anticolon/AutoLee/AutoLee/web_server.h

// ============================================================================
//  AutoLee – web_server.h
//  Web server, API endpoints, SSE broadcast, captive portal, OTA upload
// ============================================================================
#pragma once

#include <Update.h>
// All globals and forward declarations are provided by AutoLee.ino
// (single translation unit — Arduino IDE model)

// ==========================================================================
//  STATE JSON BUILDER
// ==========================================================================
// Escape a string for embedding in JSON (quotes, backslashes, control chars)
static String jsonEscape(const String &s) {
  String out;
  out.reserve(s.length() + 8);
  for (size_t i = 0; i < s.length(); i++) {
    char c = s[i];
    if (c == '"')       out += "\\\"";
    else if (c == '\\') out += "\\\\";
    else if ((uint8_t)c >= 0x20) out += c;  // drop control chars
  }
  return out;
}

static String buildStateJSON() {
  char buf[1280];
  const char *wfStat = wifiConnected ? "Connected" : (wifiAPMode ? "AP Mode" : "Disconnected");
  String wfSSID = jsonEscape(wifiConnected ? WiFi.SSID() : (wifiAPMode ? String(DEFAULT_AP_SSID) : String("—")));
  String wfIP = wifiConnected ? WiFi.localIP().toString() : (wifiAPMode ? WiFi.softAPIP().toString() : String("—"));
  int n = snprintf(buf, sizeof(buf),
    "{\"version\":\"%s\",\"state\":\"%s\",\"counter\":%ld,\"speed\":%lu,\"calibrated\":%s,"
    "\"rawUp\":%ld,\"rawDown\":%ld,\"endpointUp\":%ld,\"endpointDown\":%ld,"
    "\"upOffset\":%ld,\"downOffset\":%ld,\"position\":%ld,\"sgTrip\":%u,"
    "\"workZone\":%ld,\"currentMa\":%u,\"sgMin\":%u,\"sgMax\":%u,\"autoSG\":%s,\"sgCal\":%s,"
    "\"profileIdx\":%u,\"profileName\":\"%s\",\"pendingProfile\":%d,"
    "\"profiles\":[{\"name\":\"Slow\",\"hz\":%lu,\"sg\":%u,\"floor\":%s},"
    "{\"name\":\"Normal\",\"hz\":%lu,\"sg\":%u,\"floor\":%s},"
    "{\"name\":\"Fast\",\"hz\":%lu,\"sg\":%u,\"floor\":%s}],"
    "\"wifiEnabled\":%s,\"wifiStatus\":\"%s\",\"wifiSSID\":\"%s\",\"wifiIP\":\"%s\","
    "\"batchTarget\":%ld,\"batchCount\":%ld,\"batchActive\":%s}",
    FW_VERSION,
    runState==RUNNING?"RUNNING":runState==STOPPING?"STOPPING":runState==CALIBRATING?"CALIBRATING":runState==STALLED?"STALLED":runState==HOMING?"HOMING":"IDLE",
    counter, (unsigned long)ui_speed_hz, endpointsCalibrated?"true":"false",
    rawUp, rawDown, endpointUp, endpointDown,
    (long)upOffsetSteps, (long)downOffsetSteps,
    stepper ? stepper->getCurrentPosition() : 0L,
    RUN_SG_TRIP,
    (long)SG_WORK_ZONE_STEPS, RUN_CURRENT_MA,
    (runStrokeMinSG == 0xFFFF) ? 0 : runStrokeMinSG, runStrokeMaxSG,
    (autoSGActive || autoSGRequested) ? "true" : "false",
    sgCalibrated ? "true" : "false",
    activeProfile, profiles[activeProfile].name, (int)pendingProfile,
    (unsigned long)profiles[0].speed_hz, profiles[0].sg_trip, profileSgAtFloor(0) ? "true" : "false",
    (unsigned long)profiles[1].speed_hz, profiles[1].sg_trip, profileSgAtFloor(1) ? "true" : "false",
    (unsigned long)profiles[2].speed_hz, profiles[2].sg_trip, profileSgAtFloor(2) ? "true" : "false",
    wifiEnabled ? "true" : "false", wfStat, wfSSID.c_str(), wfIP.c_str(),
    (long)batchTarget, (long)batchCount,
    batchActive ? "true" : "false");
  // A silently truncated buffer produces invalid JSON, which the browser's
  // JSON.parse() catch{} swallows — the panel just stops updating with no
  // visible error. Fail loudly-but-validly instead.
  if (n < 0 || n >= (int)sizeof(buf)) {
    return String("{\"version\":\"" FW_VERSION "\",\"error\":\"json_truncated\"}");
  }
  return String(buf);
}

// ==========================================================================
//  INDEX HTML (control panel)
// ==========================================================================
static const char INDEX_HTML[] PROGMEM = R"rawliteral(
<!DOCTYPE html><html lang="en"><head>
<meta charset="UTF-8"><meta name="viewport" content="width=device-width,initial-scale=1">
<title>AutoLee</title>
<style>
:root{--bg:#111;--box:#1b1b1b;--card:#222;--accent:#1F6FEB;--green:#00FF00;--red:#FF4444;--text:#eee;--muted:#888;--dim:#555;--border:#333}
*{margin:0;padding:0;box-sizing:border-box}
body{font-family:-apple-system,BlinkMacSystemFont,'Segoe UI',sans-serif;background:var(--bg);color:var(--text);min-height:100vh;display:flex;justify-content:center;padding:16px 12px}
.wrap{width:100%;max-width:420px}
h1{font-size:1.5em;text-align:center;margin-bottom:2px}
.sub{color:var(--dim);font-size:.8em;text-align:center;margin-bottom:16px}
.sec{background:var(--box);border-radius:12px;padding:16px;margin-bottom:10px}
.sec h2{font-size:.85em;color:var(--muted);text-transform:uppercase;letter-spacing:.06em;margin-bottom:10px}
.badge{display:inline-block;padding:3px 10px;border-radius:10px;font-size:.75em;font-weight:600}
.badge.ok{background:#0d3320;color:var(--green)}.badge.warn{background:#3A2B12;color:#FFD37C}.badge.run{background:#331111;color:var(--red)}.badge.stall{background:#441111;color:#FF8844}
.counter{font-size:3.2em;font-weight:700;color:var(--green);text-align:center;margin:6px 0;font-variant-numeric:tabular-nums;line-height:1.1}
.btn{display:inline-block;padding:10px 20px;border:none;border-radius:8px;font-size:.9em;font-weight:600;cursor:pointer;color:#fff;text-align:center;transition:opacity .15s}
.btn:hover{opacity:.85}.btn:active{opacity:.7}.btn:disabled{opacity:.35;cursor:not-allowed}
.btn-run{background:var(--green);color:#000;font-size:1.1em;width:100%;padding:14px;border-radius:10px}.btn-run.active{background:var(--red);color:#fff}
.btn-blue{background:var(--accent)}.btn-dark{background:#333}.btn-red{background:#B42318}
.btn-sm{padding:6px 10px;font-size:.8em;border-radius:6px}
.row{display:flex;gap:6px;align-items:center;flex-wrap:wrap}.row.ctr{justify-content:center}
.sr{display:flex;justify-content:space-between;padding:3px 0;font-size:.85em}.sr .l{color:var(--muted)}.sr .v{font-weight:600;font-variant-numeric:tabular-nums}
.slider-row{display:flex;align-items:center;gap:10px;margin:6px 0}
.slider-row input[type=range]{flex:1;height:4px;-webkit-appearance:none;background:var(--border);border-radius:2px;outline:none}
.slider-row input[type=range]::-webkit-slider-thumb{-webkit-appearance:none;width:20px;height:20px;border-radius:50%;background:var(--accent);cursor:pointer}
.slider-row span{min-width:50px;text-align:right;color:#fff;font-size:.85em;font-weight:600;font-variant-numeric:tabular-nums}
.ea{display:flex;gap:3px;align-items:center;justify-content:center;margin:6px 0}
.hint{font-size:.75em;color:var(--dim);margin:2px 0 6px}
hr{border:none;border-top:1px solid var(--border);margin:10px 0}
details{margin-top:10px}
details summary{color:var(--accent);font-size:.85em;cursor:pointer;padding:4px 0;user-select:none}
details summary:hover{opacity:.8}
details[open] summary{margin-bottom:8px}
.jam-alert{display:none;background:#2a1111;border:1px solid #442222;border-radius:10px;padding:12px;margin-top:10px;text-align:center}
input[type=text],input[type=password]{width:100%;padding:10px;margin-bottom:6px;background:var(--card);border:1px solid var(--border);border-radius:8px;color:#fff;font-size:.9em}
.upload{border:2px dashed #444;border-radius:8px;padding:16px;text-align:center;color:var(--muted);cursor:pointer;font-size:.85em}
.upload:hover{border-color:var(--accent)}.upload.on{border-color:var(--green);color:var(--green)}
.pbar{width:100%;height:5px;background:#333;border-radius:3px;margin-top:6px;overflow:hidden;display:none}
.pbar .fill{height:100%;background:var(--accent);width:0%;transition:width .3s;border-radius:3px}
#otaS{font-size:.8em;margin-top:4px;min-height:1em}
.log{background:#000;border-radius:8px;padding:8px;font-family:'Courier New',monospace;font-size:.7em;color:#0f0;height:400px;overflow-y:auto;white-space:pre-wrap;word-break:break-all}
.page{display:none}.page.active{display:block}
.nav-footer{margin-top:16px;padding:14px 0;text-align:center;border-top:1px solid var(--border)}
.nav-footer a{color:var(--accent);text-decoration:none;font-size:.85em;font-weight:600;margin:0 10px;cursor:pointer}
.nav-footer a:hover{opacity:.7}
.back-link{display:inline-block;color:var(--accent);font-size:.85em;font-weight:600;cursor:pointer;margin-bottom:12px;text-decoration:none}
.back-link:hover{opacity:.7}
</style></head><body>
<div class="wrap">

<h1>AutoLee</h1>
<div class="sub">by K.L Design · <span id="ver"></span></div>

<!-- ==================== MAIN PAGE ==================== -->
<div id="pageMain" class="page active">

<!-- STATUS + COUNTER + RUN -->
<div class="sec">
<div class="row ctr" style="gap:6px;margin-bottom:6px">
<span id="cb" class="badge warn">NOT CALIBRATED</span>
<span id="sb" class="badge ok">IDLE</span></div>
<div class="counter" id="ctr">0</div>
<div id="sgwarn" style="display:none;background:#3A2B12;border:1px solid #6b5120;border-radius:8px;padding:8px;margin-bottom:8px;font-size:.8em;color:#FFD37C;text-align:center">
Jam detection is not set up. Calibrate the endpoints, then run <b>Auto SG</b> on the Config page (or set all three trips by hand) before using the press.</div>
<div id="sgfloor" style="display:none;background:#3A2B12;border:1px solid #6b5120;border-radius:8px;padding:8px;margin-bottom:8px;font-size:.8em;color:#FFD37C;text-align:center"></div>
<button class="btn btn-run" id="br" onclick="toggleRun()">RUN</button>
<div class="jam-alert" id="jamAlert">
<div style="color:#FF4444;font-weight:700;margin-bottom:4px">&#9888; JAM DETECTED</div>
<div style="color:#aaa;font-size:.8em;margin-bottom:8px">Motor stalled and backed off.</div>
<button class="btn btn-blue" onclick="doAct('return_home')" id="bh">Return Home</button>
</div>
<div class="row ctr" style="margin-top:10px;gap:8px">
<button class="btn btn-dark" onclick="doAct('calibrate')" id="bc">Calibrate</button>
<button class="btn btn-red" onclick="doAct('reset_counter')">Reset Counter</button></div>
<hr>
<h2 style="margin-top:8px">Batch Run</h2>
<div class="sr"><span class="l">Target</span><span class="v" id="btv">OFF</span></div>
<div id="btStatus" class="hint"></div>
<div class="ea">
<button class="btn btn-dark btn-sm" onclick="setBatch(-100)">-100</button>
<button class="btn btn-dark btn-sm" onclick="setBatch(-10)">-10</button>
<button class="btn btn-dark btn-sm" onclick="setBatch(-1)">-1</button>
<button class="btn btn-blue btn-sm" onclick="setBatch(1)">+1</button>
<button class="btn btn-blue btn-sm" onclick="setBatch(10)">+10</button>
<button class="btn btn-blue btn-sm" onclick="setBatch(100)">+100</button></div>
<div class="row ctr" style="margin-top:8px;gap:6px">
<button class="btn btn-blue btn-sm" onclick="doBatch('start')" id="bbStart">Start Batch</button>
<button class="btn btn-dark btn-sm" onclick="doBatch('clear')">Clear</button></div>
</div>

<!-- SPEED PROFILE -->
<div class="sec">
<h2>Speed Profile</h2>
<div class="row ctr" id="profileRow" style="gap:6px;margin-bottom:8px"></div>
<div class="sr"><span class="l">Active</span><span class="v" id="sv">-</span></div>
</div>

<!-- NAV FOOTER -->
<div class="nav-footer">
<a onclick="showPage('pageConfig')">Configuration</a>
<a onclick="showPage('pageLog')">Log</a>
<a onclick="showPage('pageFW')">Firmware</a>
<a onclick="showPage('pageWifi')">WiFi</a>
</div>

</div><!-- /pageMain -->

<!-- ==================== CONFIGURATION PAGE ==================== -->
<div id="pageConfig" class="page">
<a class="back-link" onclick="showPage('pageMain')">&#8592; Back</a>

<!-- MOTOR CURRENT -->
<div class="sec">
<h2>Motor Current</h2>
<div class="slider-row">
<input type="range" id="mcSlider" min="1000" max="4500" step="100" value="2500" oninput="showCurrent(this.value)" onchange="setCurrent(this.value)">
<span id="mcv">2500</span>
</div>
<div class="hint">Run current in mA (1000–4500). Higher = more torque, more heat. Applied when you release the slider.</div>
<div id="mcWarn" style="display:none;background:#3A2B12;border-radius:6px;padding:6px 10px;margin-top:6px;font-size:.8em;color:#FFD37C">&#9888; Above 4000 mA exceeds motor rating. Ensure adequate cooling.</div>
</div>

<!-- ENDPOINT TUNING -->
<div class="sec">
<h2>Endpoint Tuning</h2>
<div class="sr"><span class="l">Position</span><span class="v" id="cp">-</span></div>
<div class="sr"><span class="l">Effective UP</span><span class="v" id="eu">-</span></div>
<div class="sr"><span class="l">Effective DOWN</span><span class="v" id="ed">-</span></div>
<details><summary>Endpoint offsets</summary>
<div class="sr"><span class="l">RAW UP</span><span class="v" id="ru">-</span></div>
<div class="sr"><span class="l">RAW DOWN</span><span class="v" id="rd">-</span></div>
<div class="sr"><span class="l">RAW TRAVEL</span><span class="v" id="rt">-</span></div>
<hr>
<div class="hint">UP offset</div>
<div class="ea">
<button class="btn btn-dark btn-sm" onclick="adj('up',-100)">-100</button>
<button class="btn btn-dark btn-sm" onclick="adj('up',-10)">-10</button>
<button class="btn btn-dark btn-sm" onclick="adj('up',-1)">-1</button>
<button class="btn btn-blue btn-sm" onclick="adj('up',1)">+1</button>
<button class="btn btn-blue btn-sm" onclick="adj('up',10)">+10</button>
<button class="btn btn-blue btn-sm" onclick="adj('up',100)">+100</button></div>
<div class="hint" style="margin-top:8px">DOWN offset</div>
<div class="ea">
<button class="btn btn-dark btn-sm" onclick="adj('down',-100)">-100</button>
<button class="btn btn-dark btn-sm" onclick="adj('down',-10)">-10</button>
<button class="btn btn-dark btn-sm" onclick="adj('down',-1)">-1</button>
<button class="btn btn-blue btn-sm" onclick="adj('down',1)">+1</button>
<button class="btn btn-blue btn-sm" onclick="adj('down',10)">+10</button>
<button class="btn btn-blue btn-sm" onclick="adj('down',100)">+100</button></div>
</details>
</div>

<!-- STALL GUARD + WORK ZONE -->
<div class="sec">
<h2>Stall Guard (per profile)</h2>
<div class="hint">On this machine SG_RESULT <b>rises</b> under load, so a jam is detected when it goes <b>above</b> the trip value: <b>lower = more sensitive</b>. 0 disables detection for that profile (readings are still logged).</div>
<div class="sr"><span class="l">Last stroke max SG</span><span class="v" id="sgmax">-</span></div>
<div class="sr"><span class="l">Last stroke min SG</span><span class="v" id="sgmin">-</span></div>
<div class="hint">Set a profile's trip just above the highest max you see running clean. The right values are specific to your machine &mdash; measure them rather than copying someone else's.</div>
<hr>
<div class="hint" style="margin-bottom:8px"><b>Auto SG</b> runs every profile with detection disabled, records the highest SG each one reaches and sets its trip to that plus one. Takes about a minute.</div>
<div class="hint" style="color:var(--red);font-weight:700;margin-bottom:8px">Empty the press first &mdash; nothing is detecting while it measures.</div>
<button class="btn btn-dark btn-sm" id="basg" onclick="autoSg()" style="width:100%">Auto SG Calibration</button>
<div id="sgProfiles"></div>
<hr>
<div class="sr"><span class="l">Work Zone (steps)</span><span class="v" id="wzv">5500</span></div>
<div class="hint">Skip SG near DOWN endpoint (primer push area)</div>
<div class="ea">
<button class="btn btn-dark btn-sm" onclick="setWz(-500)">-500</button>
<button class="btn btn-dark btn-sm" onclick="setWz(-100)">-100</button>
<button class="btn btn-blue btn-sm" onclick="setWz(100)">+100</button>
<button class="btn btn-blue btn-sm" onclick="setWz(500)">+500</button></div>
</div>

<!-- NAV FOOTER -->
<div class="nav-footer">
<a onclick="showPage('pageMain')">Main</a>
<a onclick="showPage('pageLog')">Log</a>
<a onclick="showPage('pageFW')">Firmware</a>
<a onclick="showPage('pageWifi')">WiFi</a>
</div>

</div><!-- /pageConfig -->

<!-- ==================== LOG PAGE ==================== -->
<div id="pageLog" class="page">
<a class="back-link" onclick="showPage('pageMain')">&#8592; Back</a>

<div class="sec">
<h2>Log</h2>
<div class="log" id="logBox"></div>
<button class="btn btn-dark btn-sm" onclick="document.getElementById('logBox').textContent='';fetch('/api/log_clear',{method:'POST'})" style="margin-top:8px;width:100%">Clear Log</button>
</div>

<!-- NAV FOOTER -->
<div class="nav-footer">
<a onclick="showPage('pageMain')">Main</a>
<a onclick="showPage('pageConfig')">Configuration</a>
<a onclick="showPage('pageFW')">Firmware</a>
<a onclick="showPage('pageWifi')">WiFi</a>
</div>

</div><!-- /pageLog -->

<!-- ==================== FIRMWARE PAGE ==================== -->
<div id="pageFW" class="page">
<a class="back-link" onclick="showPage('pageMain')">&#8592; Back</a>

<div class="sec">
<h2>Firmware Update (OTA)</h2>
<div class="upload" id="ua" onclick="document.getElementById('fw').click()">
Tap to select .bin<br><span style="font-size:.8em">or drag &amp; drop</span></div>
<input type="file" id="fw" accept=".bin" style="display:none" onchange="upFW(this.files[0])">
<div class="pbar" id="pb"><div class="fill" id="pf"></div></div>
<div id="otaS"></div>
</div>

<!-- NAV FOOTER -->
<div class="nav-footer">
<a onclick="showPage('pageMain')">Main</a>
<a onclick="showPage('pageConfig')">Configuration</a>
<a onclick="showPage('pageLog')">Log</a>
<a onclick="showPage('pageWifi')">WiFi</a>
</div>

</div><!-- /pageFW -->

<!-- ==================== WIFI PAGE ==================== -->
<div id="pageWifi" class="page">
<a class="back-link" onclick="showPage('pageMain')">&#8592; Back</a>

<div class="sec">
<h2>Connection</h2>
<div class="sr"><span class="l">WiFi</span><span class="v" id="wfEn">—</span></div>
<div class="sr"><span class="l">Status</span><span class="v" id="wfStatus">—</span></div>
<div class="sr"><span class="l">SSID</span><span class="v" id="wfSSID">—</span></div>
<div class="sr"><span class="l">IP Address</span><span class="v" id="wfIP">—</span></div>
</div>

<div class="sec">
<h2>WiFi Settings</h2>
<div class="hint" style="margin-bottom:8px">Change WiFi credentials (reboot required)</div>
<input type="text" id="ns" placeholder="SSID">
<input type="password" id="np" placeholder="Password">
<div class="row" style="gap:6px">
<button class="btn btn-blue btn-sm" onclick="saveWifi()" style="flex:1">Save &amp; Reboot</button>
<button class="btn btn-red btn-sm" onclick="resetWifi()" style="flex:1">Reset WiFi</button></div>
</div>

<div class="sec">
<h2>Radio</h2>
<div class="hint" style="margin-bottom:8px">Turning WiFi off shuts down the radio, this web panel and OTA. The machine keeps running from the touch screen, and WiFi can only be turned back on there.</div>
<button class="btn btn-red btn-sm" onclick="wifiOff()" style="width:100%">Turn WiFi Off</button>
</div>

<!-- NAV FOOTER -->
<div class="nav-footer">
<a onclick="showPage('pageMain')">Main</a>
<a onclick="showPage('pageConfig')">Configuration</a>
<a onclick="showPage('pageLog')">Log</a>
<a onclick="showPage('pageFW')">Firmware</a>
</div>

</div><!-- /pageWifi -->

</div>

<script>
let es;
function sse(){es=new EventSource('/events');es.onmessage=e=>{try{upd(JSON.parse(e.data))}catch(x){}};
es.addEventListener('log',e=>{try{const d=JSON.parse(e.data);const lb=document.getElementById('logBox');
let t=lb.textContent+d.log.join('\n')+'\n';
const ln=t.split('\n');if(ln.length>500)t=ln.slice(-500).join('\n');
lb.textContent=t;lb.scrollTop=lb.scrollHeight}catch(x){}});
es.onerror=()=>{es.close();setTimeout(sse,3000)}}
sse();

function showPage(id){
  document.querySelectorAll('.page').forEach(p=>p.classList.remove('active'));
  document.getElementById(id).classList.add('active');
  window.scrollTo(0,0);
}


// Profile button text; a profile at the SG floor gets a warning marker.
function profLabel(p){
  return p.name+(p.floor?' <span style="color:#FFD37C">&#9888;</span>':'')
    +'<br><span style="font-size:.75em;opacity:.7">'+Math.round(p.hz/1000)+'kHz</span>';
}
function sgLabel(p,isActive){
  return p.name+' ('+Math.round(p.hz/1000)+'kHz) <span style="color:'+(isActive?'var(--green)':'var(--muted)')+'">SG='+p.sg+'</span>'
    +(p.floor?' <span style="color:#FFD37C">&#9888; floor</span>':'');
}
let profBuilt=false;
function buildProfileBtns(profiles,activeIdx,pendIdx){
  const row=document.getElementById('profileRow');
  if(!row)return;
  if(profBuilt){
    // Just update active highlight + queued outline
    profiles.forEach((p,i)=>{
      const b=document.getElementById('profBtn'+i);
      if(b){b.className='btn '+(i===activeIdx?'btn-blue':'btn-dark')+' btn-sm';
            b.style.outline=(i===pendIdx?'2px solid #FFD37C':'none');
            b.innerHTML=profLabel(p)}
    });
    return;
  }
  row.innerHTML='';
  profiles.forEach((p,i)=>{
    const b=document.createElement('button');
    b.id='profBtn'+i;
    b.className='btn '+(i===activeIdx?'btn-blue':'btn-dark')+' btn-sm';
    b.style.cssText='flex:1;padding:10px 4px';
    b.style.outline=(i===pendIdx?'2px solid #FFD37C':'none');
    b.innerHTML=profLabel(p);
    b.onclick=()=>setProfile(i);
    row.appendChild(b);
  });
  profBuilt=true;
}

let sgBuilt=false;
function buildSgControls(profiles,activeIdx){
  const c=document.getElementById('sgProfiles');
  if(!c)return;
  // Skip full rebuild if already built and an input is focused
  if(sgBuilt){
    // Just update the display values and highlights
    profiles.forEach((p,i)=>{
      const isActive=i===activeIdx;
      const lbl=document.getElementById('sgLbl'+i);
      const inp=document.getElementById('sgIn'+i);
      const row=document.getElementById('sgRow'+i);
      if(lbl) lbl.innerHTML=sgLabel(p,isActive);
      if(row) row.style.background=isActive?'#1a2a3a':'#161616';
      // Only update input if it's not focused (user might be typing)
      if(inp && document.activeElement!==inp) inp.value=p.sg;
    });
    return;
  }
  // First build
  c.innerHTML='';
  profiles.forEach((p,i)=>{
    const isActive=i===activeIdx;
    const div=document.createElement('div');
    div.id='sgRow'+i;
    div.style.cssText='margin-bottom:8px;padding:6px 8px;border-radius:8px;background:'+(isActive?'#1a2a3a':'#161616');
    div.innerHTML='<div class="sr" id="sgLbl'+i+'" style="margin-bottom:4px">'+sgLabel(p,isActive)+'</div>'
      +'<div style="display:flex;align-items:center;gap:8px">'
      +'<input type="text" inputmode="numeric" pattern="[0-9]*" id="sgIn'+i+'" value="'+p.sg+'" style="width:80px;padding:6px 8px;background:#222;border:1px solid #444;border-radius:6px;color:#fff;font-size:.9em;text-align:center" placeholder="0-1023">'
      +'<button class="btn btn-blue btn-sm" id="sgBtn'+i+'">Set</button>'
      +'<span style="color:var(--dim);font-size:.7em">0 – 1023</span></div>';
    c.appendChild(div);
    // Attach event listeners properly (not via inline onclick)
    document.getElementById('sgBtn'+i).addEventListener('click',function(){setSg(i)});
    document.getElementById('sgIn'+i).addEventListener('keydown',function(e){if(e.key==='Enter'){e.preventDefault();setSg(i)}});
    document.getElementById('sgIn'+i).addEventListener('blur',function(){setSg(i)});
  });
  sgBuilt=true;
}

function upd(d){
  if(d.version)document.getElementById('ver').textContent='v'+d.version;
  document.getElementById('ctr').textContent=d.counter;
  let svTxt=d.profileName+' — '+d.speed+'Hz (SG='+d.sgTrip+')';
  if(d.profiles&&d.pendingProfile>=0&&d.profiles[d.pendingProfile])svTxt+=' → '+d.profiles[d.pendingProfile].name+' next stroke';
  document.getElementById('sv').textContent=svTxt;
    document.getElementById('cp').textContent=d.position;
    document.getElementById('wzv').textContent=d.workZone;
  if(d.sgMin!==undefined){const e=document.getElementById('sgmin');if(e)e.textContent=d.sgMin>0?d.sgMin:'-'}
  if(d.sgMax!==undefined){const e=document.getElementById('sgmax');if(e)e.textContent=d.sgMax>0?d.sgMax:'-'}
  {const e=document.getElementById('basg');if(e){e.disabled=!!d.autoSG||d.state!=='IDLE';e.textContent=d.autoSG?'Measuring...':'Auto SG Calibration'}}
  if(d.wifiStatus){document.getElementById('wfStatus').textContent=d.wifiStatus;document.getElementById('wfSSID').textContent=d.wifiSSID;document.getElementById('wfIP').textContent=d.wifiIP}
  if(d.wifiEnabled!==undefined)document.getElementById('wfEn').textContent=d.wifiEnabled?'ON':'OFF';
  if(d.currentMa){
    const sl=document.getElementById('mcSlider');
    // Don't yank the slider out from under the user mid-drag.
    if(document.activeElement!==sl&&(Date.now()-mcTouched)>1500){
      document.getElementById('mcv').textContent=d.currentMa;sl.value=d.currentMa;
      document.getElementById('mcWarn').style.display=d.currentMa>4000?'block':'none';
    }
  }
  if(d.profiles){buildProfileBtns(d.profiles,d.profileIdx,d.pendingProfile);buildSgControls(d.profiles,d.profileIdx)}
  document.getElementById('btv').textContent=d.batchTarget>0?d.batchTarget:'OFF';
  const bts=document.getElementById('btStatus');
  const bbs=document.getElementById('bbStart');
  if(d.batchActive){bts.textContent='Running: '+d.batchCount+'/'+d.batchTarget;bts.style.color='var(--green)';bbs.disabled=true;bbs.textContent='Running...'}
  else if(d.batchTarget>0&&d.batchCount>=d.batchTarget){bts.textContent='Batch complete!';bts.style.color='var(--green)';bbs.disabled=false;bbs.textContent='Start Batch'}
  else{bts.textContent=d.batchTarget>0?'Ready':'Set a target count';bts.style.color='var(--muted)';bbs.disabled=d.batchTarget<=0;bbs.textContent='Start Batch'}
  const cb=document.getElementById('cb');
  cb.textContent=d.calibrated?'CALIBRATED':'NOT CALIBRATED';
  cb.className='badge '+(d.calibrated?'ok':'warn');
  const sb=document.getElementById('sb');
  sb.textContent=d.state;
  sb.className='badge '+(d.state==='RUNNING'?'run':d.state==='CALIBRATING'?'warn':d.state==='STALLED'||d.state==='HOMING'?'stall':'ok');
  const ja=document.getElementById('jamAlert');
  if(d.state==='STALLED'){ja.style.display='block';document.getElementById('bh').disabled=false;document.getElementById('bh').textContent='Return Home'}
  else if(d.state==='HOMING'){ja.style.display='block';document.getElementById('bh').disabled=true;document.getElementById('bh').textContent='Returning...'}
  else{ja.style.display='none'}
  const br=document.getElementById('br');
  if(d.state==='RUNNING'){br.textContent='STOP';br.classList.add('active')}
  else{br.textContent='RUN';br.classList.remove('active')}
  // RUN does nothing unless we're IDLE or RUNNING — reflect that in the UI.
  // The SG gate only blocks starting: STOP must stay live while RUNNING,
  // which includes a first-time Auto SG (sgCal is still false then).
  br.disabled=(d.state==='CALIBRATING'||d.state==='STALLED'||d.state==='HOMING'||d.state==='STOPPING'||(d.sgCal===false&&d.state!=='RUNNING'));
  {const w=document.getElementById('sgwarn');if(w)w.style.display=(d.sgCal===false)?'block':'none'}
  {const f=document.getElementById('sgfloor');
   const ap=(d.profiles&&d.profiles[d.profileIdx])?d.profiles[d.profileIdx]:null;
   if(f){if(d.sgCal!==false&&ap&&ap.floor){
     f.innerHTML='&#9888; <b>'+ap.name+'</b> reads at the StallGuard floor on this machine. Jam detection is <b>limited</b> and may not stop a jam. Use a slower profile when jam protection matters.';
     f.style.display='block'}else f.style.display='none'}}
  const bc=document.getElementById('bc');
  bc.disabled=d.state==='CALIBRATING';
  bc.textContent=d.state==='CALIBRATING'?'Calibrating...':'Calibrate';
  if(d.calibrated){
    document.getElementById('ru').textContent=d.rawUp;
    document.getElementById('rd').textContent=d.rawDown;
    document.getElementById('rt').textContent=d.rawDown-d.rawUp;
    document.getElementById('eu').textContent=d.endpointUp+' (off '+(d.upOffset>=0?'+':'')+d.upOffset+')';
    document.getElementById('ed').textContent=d.endpointDown+' (off '+(d.downOffset>=0?'+':'')+d.downOffset+')';
  }else{['ru','rd','rt','eu','ed'].forEach(i=>document.getElementById(i).textContent='-')}
}

function toggleRun(){fetch('/api/toggle_run',{method:'POST'})}
function autoSg(){
  if(!confirm('Run Auto SG calibration?\n\nThe press must be EMPTY - jam detection is disabled while it measures, and it runs all three speed profiles for about a minute.'))return;
  fetch('/api/action?do=auto_sg',{method:'POST'})}
function setSg(p){const v=parseInt(document.getElementById('sgIn'+p).value)||0;fetch('/api/sg_trip?profile='+p+'&value='+v,{method:'POST'})}
function setWz(d){fetch('/api/work_zone?delta='+d,{method:'POST'})}
function setBatch(d){fetch('/api/batch?delta='+d,{method:'POST'})}
function doBatch(a){fetch('/api/batch?action='+a,{method:'POST'})}
function setProfile(i){fetch('/api/profile?idx='+i,{method:'POST'})}
let mcTouched=0;
function showCurrent(v){mcTouched=Date.now();document.getElementById('mcv').textContent=v;document.getElementById('mcWarn').style.display=v>4000?'block':'none'}
function setCurrent(v){mcTouched=Date.now();showCurrent(v);fetch('/api/current?ma='+v,{method:'POST'})}
function adj(w,d){fetch('/api/endpoint?which='+w+'&delta='+d,{method:'POST'})}
function doAct(a){fetch('/api/action?do='+a,{method:'POST'})}
function saveWifi(){
  const s=document.getElementById('ns').value,p=document.getElementById('np').value;
  if(!s){alert('SSID required');return}
  fetch('/api/wifi?ssid='+encodeURIComponent(s)+'&pass='+encodeURIComponent(p),{method:'POST'})
  .then(()=>{alert('Saved! Rebooting...');setTimeout(()=>location.reload(),5000)})}
function wifiOff(){
  if(!confirm('Turn WiFi off? This page and OTA will stop working. You can only turn it back on from the WiFi screen on the device.'))return;
  fetch('/api/wifi_enable?on=0',{method:'POST'})
  .then(()=>{alert('WiFi shutting down.')})}
function resetWifi(){
  if(!confirm('Clear saved WiFi credentials and reboot into setup mode?'))return;
  fetch('/api/wifi_reset',{method:'POST'})
  .then(()=>{alert('WiFi cleared! Rebooting into setup mode...');setTimeout(()=>location.reload(),5000)})}

function upFW(f){
  if(!f)return;
  const ua=document.getElementById('ua'),pb=document.getElementById('pb'),pf=document.getElementById('pf'),st=document.getElementById('otaS');
  ua.classList.add('on');ua.textContent=f.name;pb.style.display='block';pf.style.width='0%';
  st.textContent='Uploading...';st.style.color='#888';
  const x=new XMLHttpRequest();x.open('POST','/api/ota');
  x.upload.onprogress=e=>{if(e.lengthComputable){const p=Math.round(e.loaded/e.total*100);pf.style.width=p+'%';st.textContent='Uploading... '+p+'%'}};
  x.onload=()=>{if(x.status===200){pf.style.width='100%';st.textContent='Success! Rebooting...';st.style.color='#00FF00';setTimeout(()=>location.reload(),5000)}
  else{st.textContent='Error: '+x.responseText;st.style.color='#FF4444'}};
  x.onerror=()=>{st.textContent='Upload failed';st.style.color='#FF4444'};
  const fd=new FormData();fd.append('firmware',f);x.send(fd)}

const uae=document.getElementById('ua');
uae.addEventListener('dragover',e=>{e.preventDefault();uae.classList.add('on')});
uae.addEventListener('dragleave',()=>uae.classList.remove('on'));
uae.addEventListener('drop',e=>{e.preventDefault();upFW(e.dataTransfer.files[0])});
fetch('/api/state').then(r=>r.json()).then(upd).catch(()=>{});
</script></body></html>
)rawliteral";

// ==========================================================================
//  WiFi Setup Page (captive portal)
// ==========================================================================
static const char WIFI_CSS[] PROGMEM =
  "body{font-family:-apple-system,sans-serif;background:#111;color:#eee;padding:20px;}"
  "h2{color:#7cf;}"
  "input,select{width:100%;padding:12px;margin:6px 0;border-radius:8px;"
  "border:1px solid #444;background:#222;color:#fff;box-sizing:border-box;}"
  "button{width:100%;padding:12px;margin-top:10px;border:none;border-radius:8px;"
  "color:#fff;font-size:16px;cursor:pointer;}"
  ".btnSave{background:#28a745;}.btnClear{background:#c0392b;}"
  ".box{max-width:420px;margin:auto;background:#1b1b1b;padding:20px;border-radius:12px;}"
  "label{display:block;margin-top:10px;font-size:14px;color:#aaa;}";

static String wifiConfigPage() {
  String html;
  html.reserve(3000);
  html += "<!DOCTYPE html><html><head><meta name='viewport' content='width=device-width,initial-scale=1'>";
  html += "<title>AutoLee WiFi Setup</title><style>";
  html += FPSTR(WIFI_CSS);
  html += "</style></head><body><div class='box'>";
  html += "<h2>AutoLee WiFi Setup</h2>";
  html += "<p style='color:#aaa;font-size:13px;'>by K.L Design</p>";
  html += "<form method='POST' action='/save'>";
  html += "<label>Select Network</label><select name='ssid_select'>" + scannedOptionsHTML + "</select>";
  html += "<label>Or type SSID manually</label><input name='ssid_manual' placeholder='SSID (optional)'>";
  html += "<label>Password</label><input name='pass' type='password' placeholder='WiFi password'>";
  html += "<button class='btnSave' type='submit'>Save &amp; Reboot</button></form>";
  html += "<form method='POST' action='/clear'><button class='btnClear' type='submit'>Clear Saved WiFi</button></form>";
  html += "</div></body></html>";
  return html;
}

// Registered unconditionally at boot: WiFi can be switched on later and come
// up in AP mode, long after setupWebServer() ran. The redirect is gated on
// captivePortalRunning at request time instead of at registration time.
static void setupCaptiveProbeEndpoints() {
  const char* probes[] = {
    "/generate_204", "/gen_204", "/hotspot-detect.html",
    "/library/test/success.html", "/ncsi.txt", "/connecttest.txt", "/fwlink"
  };
  for (auto &p : probes)
    webServer.on(p, HTTP_GET, [](AsyncWebServerRequest *r){
      if (captivePortalRunning) r->redirect("/");
      else r->send(404, "text/plain", "Not found");
    });
}

static void setupWebServer() {
  // Root page: WiFi config in AP mode, control panel in STA mode
  webServer.on("/", HTTP_GET, [](AsyncWebServerRequest *req) {
    if (wifiAPMode && !wifiConnected) {
      req->send(200, "text/html", wifiConfigPage());
    } else {
      req->send_P(200, "text/html", INDEX_HTML);
    }
  });

  // WiFi setup save (captive portal)
  webServer.on("/save", HTTP_POST, [](AsyncWebServerRequest *req) {
    String ss, sm, pw;
    if (req->hasParam("ssid_select", true)) ss = req->getParam("ssid_select", true)->value();
    if (req->hasParam("ssid_manual", true)) sm = req->getParam("ssid_manual", true)->value();
    if (req->hasParam("pass", true))        pw = req->getParam("pass", true)->value();
    sm.trim(); ss.trim();
    String finalSSID = sm.length() ? sm : ss;
    if (finalSSID.length() == 0) {
      req->send(400, "text/html",
        "<html><body style='font-family:sans-serif;text-align:center;padding:40px;background:#111;color:#eee;'>"
        "<h2>Missing SSID</h2><p><a href='/' style='color:#7cf;'>Go back</a></p></body></html>");
      return;
    }
    // Deferred to loop(): NVS writes must not run in the AsyncTCP task
    // (they block the TCP stack and share the global Preferences object).
    pendingWifiSSID = finalSSID;
    pendingWifiPass = pw;
    webWifiSaveRequested = true;
    req->send(200, "text/html",
      "<html><body style='font-family:sans-serif;text-align:center;padding:40px;background:#111;color:#eee;'>"
      "<h2 style='color:#28a745;'>Saved!</h2><p>Rebooting...</p></body></html>");
  });

  // WiFi clear
  webServer.on("/clear", HTTP_POST, [](AsyncWebServerRequest *req) {
    webWifiClearRequested = true;   // deferred to loop() — NVS write
    req->send(200, "text/html",
      "<html><body style='font-family:sans-serif;text-align:center;padding:40px;background:#111;color:#eee;'>"
      "<h2>WiFi Cleared</h2><p>Rebooting...</p></body></html>");
  });

  events.onConnect([](AsyncEventSourceClient *client) {
    client->send(buildStateJSON().c_str(), NULL, millis(), 500);
  });
  webServer.addHandler(&events);

  webServer.on("/api/state", HTTP_GET, [](AsyncWebServerRequest *req) {
    req->send(200, "application/json", buildStateJSON());
  });

  webServer.on("/api/toggle_run", HTTP_POST, [](AsyncWebServerRequest *req) {
    // Deferred to loop(): touches stepper, TMC5160 SPI, and LVGL
    webToggleRunRequested = true;
    req->send(200, "text/plain", "ok");
  });

  webServer.on("/api/profile", HTTP_POST, [](AsyncWebServerRequest *req) {
    if (req->hasParam("idx")) {
      uint8_t idx = (uint8_t)req->getParam("idx")->value().toInt();
      if (idx < NUM_PROFILES) {
        // Deferred to loop(): setActiveProfile touches stepper and LVGL
        webProfileRequested = (int8_t)idx;
      }
    }
    req->send(200, "text/plain", "ok");
  });

  webServer.on("/api/current", HTTP_POST, [](AsyncWebServerRequest *req) {
    if (req->hasParam("ma")) {
      // Deferred to loop(): rms_current() is an SPI write that could collide
      // with read_sg() polling on the shared display/TMC bus
      webCurrentMaRequested = req->getParam("ma")->value().toInt();
    }
    req->send(200, "text/plain", "ok");
  });

  webServer.on("/api/endpoint", HTTP_POST, [](AsyncWebServerRequest *req) {
    // Deferred to loop(): endpointUp/endpointDown are read by handleMotion()
    // on every pass, so they must not be rewritten from the AsyncTCP task.
    if (req->hasParam("which") && req->hasParam("delta")) {
      String w = req->getParam("which")->value();
      int32_t d = req->getParam("delta")->value().toInt();
      if (w == "up") webUpOffsetDelta   = webUpOffsetDelta + d;
      else           webDownOffsetDelta = webDownOffsetDelta + d;
    }
    req->send(200, "text/plain", "ok");
  });

  webServer.on("/api/sg_trip", HTTP_POST, [](AsyncWebServerRequest *req) {
    // Deferred to loop(): handleMotion() reads RUN_SG_TRIP every pass.
    int8_t tgt = (int8_t)activeProfile;
    if (req->hasParam("profile")) {
      int32_t p = req->getParam("profile")->value().toInt();
      if (p >= 0 && p < (int32_t)NUM_PROFILES) tgt = (int8_t)p;
    }
    if (req->hasParam("value")) {
      // Absolute value (from web text input)
      webSgDelta    = 0;
      webSgAbsolute = req->getParam("value")->value().toInt();
      webSgProfile  = tgt;           // publish last
    } else if (req->hasParam("delta")) {
      // Relative delta
      webSgAbsolute = -1;
      webSgDelta    = req->getParam("delta")->value().toInt();
      webSgProfile  = tgt;           // publish last
    }
    req->send(200, "text/plain", "ok");
  });

  webServer.on("/api/work_zone", HTTP_POST, [](AsyncWebServerRequest *req) {
    // Deferred to loop(): read by handleMotion() every pass.
    if (req->hasParam("delta")) {
      int32_t d = req->getParam("delta")->value().toInt();
      webWorkZoneDelta = webWorkZoneDelta + d;
    }
    req->send(200, "text/plain", "ok");
  });

  webServer.on("/api/batch", HTTP_POST, [](AsyncWebServerRequest *req) {
    // All of these are read by handleMotion() — deferred to loop().
    if (req->hasParam("delta")) {
      int32_t d = req->getParam("delta")->value().toInt();
      webBatchDelta = webBatchDelta + d;
    }
    if (req->hasParam("action")) {
      String a = req->getParam("action")->value();
      if (a == "start") {
        // startRunBetweenEndpoints touches stepper, TMC5160 SPI and LVGL.
        // Validity is re-checked in loop().
        webBatchStartRequested = true;
      } else if (a == "clear") {
        webBatchClearRequested = true;
      }
    }
    req->send(200, "text/plain", "ok");
  });

  webServer.on("/api/action", HTTP_POST, [](AsyncWebServerRequest *req) {
    if (req->hasParam("do")) {
      String action = req->getParam("do")->value();
      // !autoSGActive: runState is briefly IDLE between two Auto SG profiles.
      if (action == "auto_sg" && runState == IDLE && !autoSGActive) {
        autoSGRequested = true;
      } else if (action == "calibrate" && runState == IDLE && !autoSGActive) {
        calRequested = true;
      } else if (action == "return_home" && runState == STALLED) {
        homeRequested = true;
      } else if (action == "reset_counter") {
        // Plain 32-bit write is safe here; the label is refreshed by
        // counter_timer_cb (100ms LVGL timer) — no direct LVGL call needed.
        counter = 0;
        markSettingsDirty();
      }
    }
    req->send(200, "text/plain", "ok");
  });

  webServer.on("/api/wifi", HTTP_POST, [](AsyncWebServerRequest *req) {
    if (req->hasParam("ssid")) {
      // Deferred to loop() — NVS write (see /save above).
      pendingWifiSSID = req->getParam("ssid")->value();
      pendingWifiPass = req->hasParam("pass") ? req->getParam("pass")->value() : String("");
      webWifiSaveRequested = true;
      req->send(200, "text/plain", "saved");
    } else {
      req->send(400, "text/plain", "ssid required");
    }
  });

  webServer.on("/api/wifi_reset", HTTP_POST, [](AsyncWebServerRequest *req) {
    webWifiClearRequested = true;   // deferred to loop() — NVS write
    req->send(200, "text/plain", "cleared");
  });

  webServer.on("/api/log_clear", HTTP_POST, [](AsyncWebServerRequest *req) {
    // Deferred to loop(): clearing the ring buffer here races with webLog()
    webLogClearRequested = true;
    req->send(200, "text/plain", "ok");
  });

  // Captive portal probe endpoints (redirect to root while the AP is up)
  setupCaptiveProbeEndpoints();
  webServer.onNotFound([](AsyncWebServerRequest *r) {
    if (captivePortalRunning) r->redirect("/");
    else r->send(404, "text/plain", "Not found");
  });

  webServer.on("/api/wifi_enable", HTTP_POST, [](AsyncWebServerRequest *req) {
    // Deferred to loop(): startWiFi() blocks, and tearing the socket down
    // from inside its own request handler would be unwise.
    if (req->hasParam("on")) {
      int v = req->getParam("on")->value().toInt();
      wifiEnableRequested = (v != 0) ? 1 : 0;
    }
    req->send(200, "text/plain", "ok");
  });

  // OTA firmware upload
  webServer.on("/api/ota", HTTP_POST,
    [](AsyncWebServerRequest *req) {
      bool ok = !Update.hasError();
      if (ok) {
        req->send(200, "text/plain", "OK");
        rebootRequestMs = millis();   // before the flag: loop() reads both
        rebootRequested = true;
      } else {
        req->send(500, "text/plain", String("Update failed: ") + Update.errorString());
      }
    },
    [](AsyncWebServerRequest *req, const String &filename, size_t index,
       uint8_t *data, size_t len, bool final) {
      if (index == 0) {
        Serial.printf("OTA: upload '%s'\n", filename.c_str());
        // Stop motor if running — deferred to loop() (stepper calls must not
        // run in the AsyncTCP task). loop() keeps running during the upload,
        // so the stop executes within milliseconds.
        if (runState == RUNNING) webStopRequested = true;
        batchActive = false;
        if (!Update.begin(UPDATE_SIZE_UNKNOWN)) {
          Update.printError(Serial);
          return;
        }
      }
      if (Update.isRunning()) {
        if (Update.write(data, len) != len) {
          Update.printError(Serial);
          Update.abort();   // otherwise every later chunk fails silently too
          return;
        }
      }
      if (final) {
        if (Update.isRunning() && Update.end(true))
          Serial.printf("OTA: success, %u bytes\n", index + len);
        else
          Update.printError(Serial);
      }
    }
  );

  // NOTE: no webServer.begin() here. The listening socket is opened by
  // wifiStartServices() and closed by wifiStopServices(), so the WiFi master
  // switch can start and stop it without re-registering handlers.
  Serial.println("Web server handlers registered");
}

// Calibration is long and blocking. It is ALWAYS run from here (loop()), so
// the nested lv_timer_handler() calls inside it really do drive the display.
void handleCalibrationRequest() {
  if (!calRequested) return;
  calRequested = false;
  if (runState != IDLE) { ui_update_cal_button(); return; }
  bool ok = calibrateEndpointsSensorless();
  calFailed = !ok;
  ui_update_cal_button();
  ui_update_main_warning();
  recomputeEffectiveEndpoints();
  ui_update_tuning_numbers();
  ui_update_endpoint_edit_values();
  setRunButtonState(false);
  markSettingsDirty();
}

// Auto SG is long and blocking, like calibration, and is likewise ALWAYS run
// from here (loop()) so the lv_timer_handler() calls inside it drive the
// display and the touch RUN button can abort it.
void handleAutoSGRequest() {
  if (!autoSGRequested) return;
  autoSGRequested = false;
  if (runState != IDLE) { ui_update_autosg_button(); return; }
  bool ok = autoCalibrateSG();
  autoSGFailed = !ok;
  ui_update_autosg_button();
  setRunButtonState(false);
}

void handleHomeRequest() {
  if (!homeRequested) return;
  homeRequested = false;
  if (runState != STALLED) return;
  safeCreepHome();
}

// ==========================================================================
//  DEFERRED WEB REQUEST PROCESSING — called from loop()
//  Async web handlers run in the AsyncTCP task. Anything touching the
//  TMC5160 (shared SPI bus with the display), the stepper, LVGL (not
//  thread-safe), or the log ring buffer is processed here instead.
// ==========================================================================
void handleWebRequests() {
  handleCalibrationRequest();
  handleHomeRequest();
  handleAutoSGRequest();

  if (wifiEnableRequested >= 0) {
    bool en = (wifiEnableRequested == 1);
    wifiEnableRequested = -1;
    setWifiEnabled(en);
  }

  if (webToggleRunRequested) {
    webToggleRunRequested = false;
    if (runState == IDLE) {
      startRunBetweenEndpoints();
      setRunButtonState(runState == RUNNING);
    } else if (runState == RUNNING) {
      requestGracefulStop();     // also clears batchActive
      setRunButtonState(false);
    }
  }

  if (webStopRequested) {
    webStopRequested = false;
    if (runState == RUNNING) {
      requestGracefulStop();     // also clears batchActive
      setRunButtonState(false);
    }
  }

  if (webBatchStartRequested) {
    webBatchStartRequested = false;
    if (batchTarget > 0 && runState == IDLE && endpointsCalibrated && sgCalibrated) {
      batchCount = 0;
      batchActive = true;
      startRunBetweenEndpoints();
      setRunButtonState(true);
    }
  }

  if (webBatchClearRequested) {
    webBatchClearRequested = false;
    batchTarget = 0;
    batchCount  = 0;
    batchActive = false;
    markSettingsDirty();
    ui_update_batch_val();
    ui_update_batch_remain();
  }

  if (webBatchDelta != 0) {
    int32_t d = webBatchDelta;
    webBatchDelta = 0;
    batchTarget = clamp_i32(batchTarget + d, 0, 9999);
    markSettingsDirty();
    ui_update_batch_val();
  }

  if (webProfileRequested >= 0) {
    int8_t p = webProfileRequested;
    webProfileRequested = -1;
    if (p < (int8_t)NUM_PROFILES && runState != CALIBRATING && runState != HOMING)
      setActiveProfile((uint8_t)p);   // queues it if we're running
  }

  // A switch queued during a run that ended before the next direction change
  // (batch finished, STOP pressed, jam) would otherwise sit here forever.
  if (pendingProfile >= 0 && runState == IDLE) applyPendingProfile();

  if (webCurrentMaRequested >= 0) {
    int32_t ma = webCurrentMaRequested;
    webCurrentMaRequested = -1;
    RUN_CURRENT_MA = (uint16_t)constrain(ma, (int32_t)RUN_CURRENT_MIN, (int32_t)RUN_CURRENT_MAX);
    if (runState != CALIBRATING && runState != HOMING) driver.rms_current(RUN_CURRENT_MA);
    markSettingsDirty();
    webLog("Current set to %u mA", RUN_CURRENT_MA);
    if (sgCalibrated && sgCalCurrentMa > 0 && RUN_CURRENT_MA != sgCalCurrentMa)
      webLog("NOTE: SG trips were measured at %u mA — re-run Auto SG at the new current",
             sgCalCurrentMa);
  }

  if (webUpOffsetDelta != 0 || webDownOffsetDelta != 0) {
    int32_t du = webUpOffsetDelta, dd = webDownOffsetDelta;
    webUpOffsetDelta = 0; webDownOffsetDelta = 0;
    if (endpointsCalibrated) {
      upOffsetSteps   = clamp_i32(upOffsetSteps + du, OFFSET_MIN, OFFSET_MAX);
      downOffsetSteps = clamp_i32(downOffsetSteps + dd, OFFSET_MIN, OFFSET_MAX);
      recomputeEffectiveEndpoints();
      markSettingsDirty();
      ui_update_endpoint_edit_values();
      ui_update_tuning_numbers();
    }
  }

  if (webWorkZoneDelta != 0) {
    int32_t d = webWorkZoneDelta;
    webWorkZoneDelta = 0;
    SG_WORK_ZONE_STEPS = clamp_i32(SG_WORK_ZONE_STEPS + d, SG_WORK_ZONE_MIN, SG_WORK_ZONE_MAX);
    markSettingsDirty();
    webLog("Work zone set to %ld steps", (long)SG_WORK_ZONE_STEPS);
    if (sgCalibrated)
      webLog("NOTE: the work zone decides which part of the stroke Auto SG measured — re-run it");
  }

  if (webSgProfile >= 0) {
    int8_t   p     = webSgProfile;
    int32_t  absV  = webSgAbsolute;
    int32_t  delta = webSgDelta;
    webSgProfile = -1; webSgAbsolute = -1; webSgDelta = 0;
    if (p < (int8_t)NUM_PROFILES) {
      int32_t v = (absV >= 0) ? absV : ((int32_t)profiles[p].sg_trip + delta);
      profiles[p].sg_trip = (uint16_t)constrain(v, (int32_t)RUN_SG_TRIP_MIN, (int32_t)RUN_SG_TRIP_MAX);
      // Set up only while EVERY profile has a trip; re-locks on a 0.
      sgCalibrated = allSgTripsSet();
      markSettingsDirty();
      ui_update_main_warning();
      ui_update_sg_val();
      ui_update_profile_screen();
      webLog("SG trip [%s] = %u", profiles[p].name, profiles[p].sg_trip);
    }
  }

  if (webWifiSaveRequested) {
    webWifiSaveRequested = false;
    saveWiFiCredentials(pendingWifiSSID, pendingWifiPass);
    webLog("WiFi credentials saved, rebooting...");
    rebootRequestMs = millis();   // before the flag: loop() reads both
    rebootRequested = true;
  }

  if (webWifiClearRequested) {
    webWifiClearRequested = false;
    clearWiFiCredentials();
    webLog("WiFi credentials cleared, rebooting...");
    rebootRequestMs = millis();   // before the flag: loop() reads both
    rebootRequested = true;
  }

  if (webLogClearRequested) {
    webLogClearRequested = false;
    logHead = 0;
    logSerial = 0;
    logSentSerial = 0;
    memset(logBuf, 0, sizeof(logBuf));
  }
}

void broadcastState() {
  if (!wifiEnabled) return;
  uint32_t now = millis();
  if ((now - lastSSEMs) < SSE_INTERVAL_MS) return;
  lastSSEMs = now;
  if (events.count() == 0) return;
  events.send(buildStateJSON().c_str(), NULL, millis());

  // Send only NEW log lines since last broadcast
  if (logSerial > logSentSerial) {
    uint32_t pending = logSerial - logSentSerial;
    // Can't send more than what's in the ring buffer, and cap the payload
    // per broadcast. Anything older is dropped (logSentSerial jumps to
    // logSerial below), which is why there is no bookkeeping to do here.
    if (pending > LOG_LINES) pending = LOG_LINES;
    if (pending > 20)        pending = 20;
    String logJson = "{\"log\":[";
    uint16_t startIdx = (logHead + LOG_LINES - (uint16_t)pending) % LOG_LINES;
    for (uint16_t i = 0; i < (uint16_t)pending; i++) {
      uint16_t idx = (startIdx + i) % LOG_LINES;
      if (i > 0) logJson += ',';
      logJson += '"';
      for (const char *p = logBuf[idx]; *p; p++) {
        if (*p == '"') logJson += "\\\"";
        else if (*p == '\\') logJson += "\\\\";
        else logJson += *p;
      }
      logJson += '"';
    }
    logJson += "]}";
    events.send(logJson.c_str(), "log", millis());
    logSentSerial = logSerial;
  }
}
