anticolon/AutoLee/(commit log)

2026-02-16 Updated Default Stallguard settings
2026-03-16 Update README.md
    Added link to 3D printable parts.
2026-03-16 Update README.md
    Added hardware list, nuts & bolts.
2026-03-16 Update README.md
    Added emergency stop button
2026-03-16 Update README.md
    3.3volt from buck converter to waveshare board.
2026-03-20 Update AutoLee.ino
    stallguard to default 375 for slow
    [AutoLee.ino]
2026-03-20 Update README.md
    Stallguard is default 375 for slow profile
2026-03-21 AutoLee v1.8
    v1.8 — Modular firmware split
    Split the 2,545-line monolith into separate files for maintainability:
    - config.h — pin definitions, speed profiles, all tuning constants
    - motion.h — motion control, stall detection, calibration, creep home
    - ui_touch.h — LVGL touch UI screens, helpers, event handlers
    - web_server.h — web server, API endpoints, SSE, HTML, OTA upload
    - wifi_ota.h — WiFi connection, captive portal, ArduinoOTA
    - globals.h — reference document (not included in build)
    - AutoLee.ino — thin spine: globals, setup(), loop(), include order
    No functional changes. Every function, API endpoint, constant, and UI
    element is i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
    [AutoLee.ino, config.h, motion.h, ui_touch.h, web_server.h, wifi_ota.h]
2026-03-26 Update README.md
    Added some more links to wires and crimping tools.
2026-08-27 Fix Amazon link for WaveShare 1.47" ESP32-C6
    Updated the Amazon link for the WaveShare 1.47" ESP32-C6 component.
2026-09-27 upload v1.32
    v1.32: Auto SG calibration, safety lockout, new speed defaults
    - Auto SG: measures per-profile SG trips; press locked until run
    - Trips tied to speed/current; changes force re-calibration
    - Warning when a profile reads at SG floor (jam detection limited)
    - Speeds 15/30/40 kHz; profile switch applied at next stroke
    - Explicit chopper config (TOFF 5, TBL 2)
    - NVS persistence, WiFi on/off + reconnect, stability fixes
    [AutoLee.ino, config.h, motion.h, ui_touch.h, web_server.h, wifi_ota.h]
2026-09-27 Wiringdiagram for 36v version
2026-09-27 Wiring schematics for 36v version
2026-09-28 Revise README.md for 36v version.
    Updated README.md with 36v version.
2026-09-28 Revise affiliate links and update wiring details
    Updated affiliate links and clarified wire specifications.
